mariosgit/performer-hardware/sequencer.kicad_pcb

## KiCad design sequencer.kicad_pcb (continued)

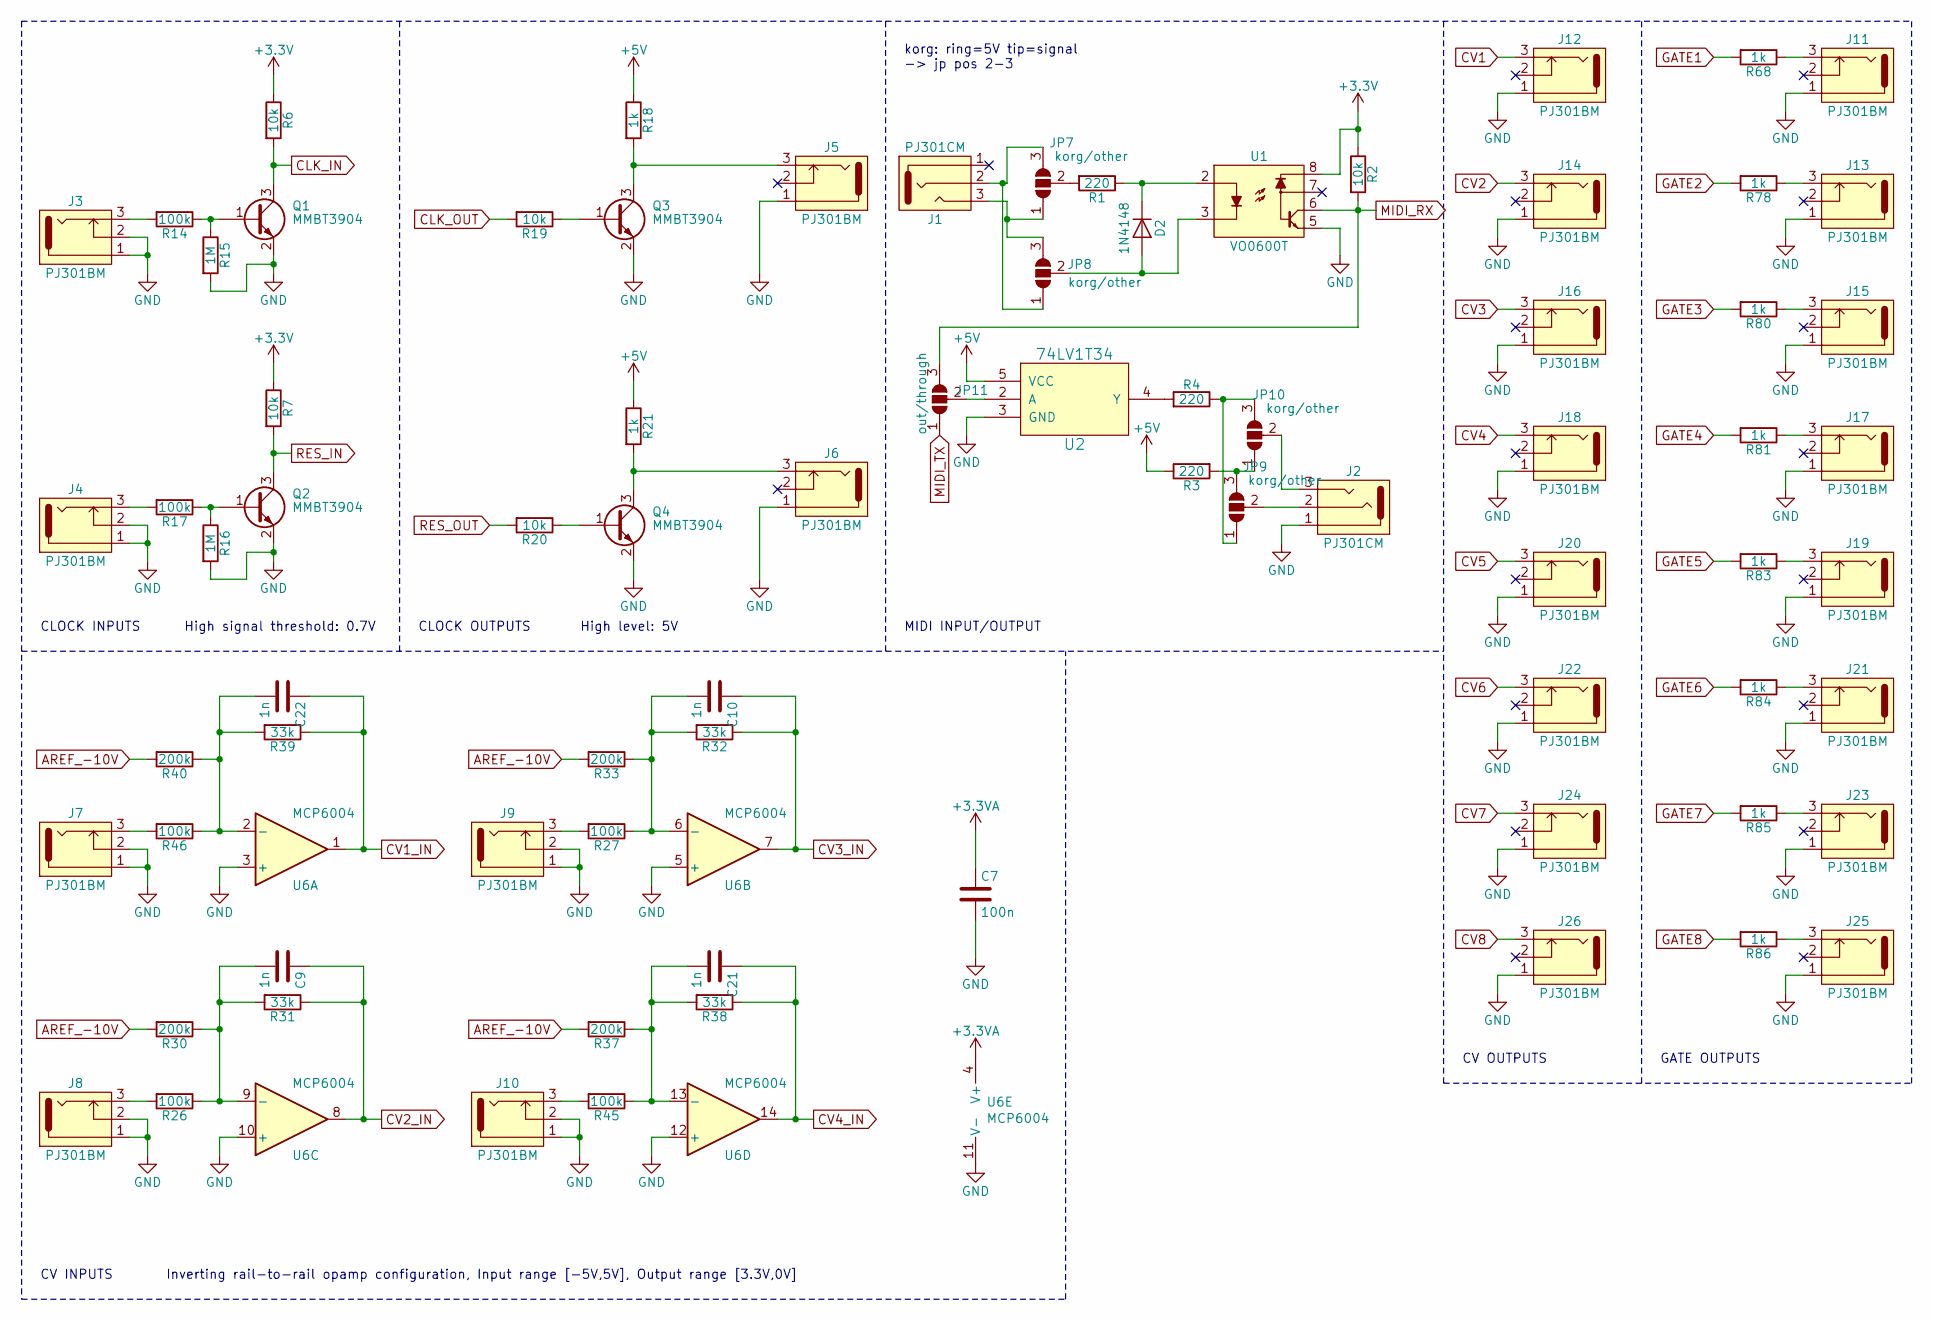
[picture p6: schematic jacks.sch, PER|FORMER eurorack sequencer]

Parts:
C7: 100n; C_0603
C9, C10, C21: 1n; C_0603
C22: 1n; C_0603; LCSC C1588
D2: 1N4148; D_SOD-123
J1, J2: PJ301CM; PJ301CM_OFFSET
J3, J4, J5, J6, J7, J8, J9, J10, J11, J12, J13, J14, J15, J16, J17, J18, J19, J20, J21, J22, J23, J24, J25, J26: PJ301BM
JP7, JP8, JP9, JP10: korg/other; SolderJumper-3_P1.3mm_Open_Pad1.0x1.5mm
JP11: out/through; SolderJumper-3_P1.3mm_Open_Pad1.0x1.5mm
Q1, Q2, Q3, Q4: MMBT3904; SOT-23
R1: 220; R_0603; LCSC C22962
R2, R6, R7, R19, R20: 10k; R_0603
R3, R4: 220; R_0603
R14, R17, R26, R27, R45, R46: 100k; R_0603
R15, R16: 1M; R_0603
R18, R21, R68, R78, R80, R81, R83, R84, R85, R86: 1k; R_0603
R30, R33, R37: 200k; R_0603
R31, R32, R38, R39: 33k; R_0603
R40: 200k; R_0603; LCSC C25811
U1: VO0600T; SOIC-8_3.9x4.9mm_P1.27mm
U2: 74LV1T34; SOT-23-5; LCSC C100024
U6: MCP6004; SOIC-14_3.9x8.7mm_P1.27mm; LCSC C7378

Connections:
+3.3VA: C7.1, U6.4 (V+); also elsewhere on the board
+5V: R3.1, R18.1, R21.1, U2.5 (VCC); also elsewhere on the board
AREF_-10V: R30.2, R33.2, R37.2, R40.2; also elsewhere on the board
CLK_IN: Q1.3 (C), R6.2; also elsewhere on the board
CLK_OUT: R19.2; also elsewhere on the board
CV1: J12.3; also elsewhere on the board
CV1_IN: C22.1, R39.1, U6.1; also elsewhere on the board
CV2: J14.3; also elsewhere on the board
CV2_IN: C9.1, R31.1, U6.8; also elsewhere on the board
CV3: J16.3; also elsewhere on the board
CV3_IN: C10.1, R32.1, U6.7; also elsewhere on the board
CV4: J18.3; also elsewhere on the board
CV4_IN: C21.1, R38.1, U6.14; also elsewhere on the board
CV5: J20.3; also elsewhere on the board
CV6: J22.3; also elsewhere on the board
CV7: J24.3; also elsewhere on the board
CV8: J26.3; also elsewhere on the board
GATE1: R68.2; also elsewhere on the board
GATE2: R78.2; also elsewhere on the board
GATE3: R80.2; also elsewhere on the board
GATE4: R81.2; also elsewhere on the board
GATE5: R83.2; also elsewhere on the board
GATE6: R84.2; also elsewhere on the board
GATE7: R85.2; also elsewhere on the board
GATE8: R86.2; also elsewhere on the board
GND: C7.2, J2.1, J3.1, J3.2, J4.1, J4.2, J5.1, J6.1, J7.1, J7.2, J8.1, J8.2, J9.1, J9.2, J10.1, J10.2, J11.1, J12.1, J13.1, J14.1, J15.1, J16.1, J17.1, J18.1, J19.1, J20.1, J21.1, J22.1, J23.1, J24.1, J25.1, J26.1, Q1.2 (E), Q2.2 (E), Q3.2 (E), Q4.2 (E), R15.2, R16.2, U1.5, U2.3 (GND), U6.3 (+), U6.5 (+), U6.10 (+), U6.11 (V-), U6.12 (+); also elsewhere on the board
MIDI_RX: JP11.3 (B), R2.2, U1.6; also elsewhere on the board
MIDI_TX: JP11.1 (A); also elsewhere on the board
unnamed: C9.2, R26.1, R30.1, R31.2, U6.9 (-)
unnamed: C10.2, R27.1, R32.2, R33.1, U6.6 (-)
unnamed: C21.2, R37.1, R38.2, R45.1, U6.13 (-)
unnamed: C22.2, R39.2, R40.1, R46.1, U6.2 (-)
unnamed: D2.1 (K), R1.1, U1.2
unnamed: D2.2 (A), JP8.2 (C), U1.3
unnamed: J1.2, JP7.3 (B), JP8.1 (A)
unnamed: J1.3, JP7.1 (A), JP8.3 (B)
unnamed: J2.2, JP9.2 (C)
unnamed: J2.3, JP10.2 (C)
unnamed: J3.3, R14.2
unnamed: J4.3, R17.2
unnamed: J5.3, Q3.3 (C), R18.2
unnamed: J6.3, Q4.3 (C), R21.2
unnamed: J7.3, R46.2
unnamed: J8.3, R26.2
unnamed: J9.3, R27.2
unnamed: J10.3, R45.2
unnamed: J11.3, R68.1
unnamed: J13.3, R78.1
unnamed: J15.3, R80.1
unnamed: J17.3, R81.1
unnamed: J19.3, R83.1
unnamed: J21.3, R84.1
unnamed: J23.3, R85.1
unnamed: J25.3, R86.1
unnamed: JP7.2 (C), R1.2
unnamed: JP9.3 (B), JP10.1 (A), R3.2
unnamed: JP9.1 (A), JP10.3 (B), R4.1
unnamed: JP11.2 (C), U2.2 (A)
unnamed: Q1.1 (B), R14.1, R15.1
unnamed: Q2.1 (B), R16.1, R17.1
unnamed: Q3.1 (B), R19.1
unnamed: Q4.1 (B), R20.1
unnamed: R4.2, U2.4 (Y)
RES_IN: Q2.3 (C), R7.2; also elsewhere on the board
RES_OUT: R20.2; also elsewhere on the board

Notes on the sheet:
CLOCK INPUTS
GATE OUTPUTS
CV OUTPUTS
MIDI INPUT/OUTPUT
CLOCK OUTPUTS
CV INPUTS
High signal threshold: 0.7V
High level: 5V
Inverting rail-to-rail opamp configuration, Input range [-5V,5V], Output range [3.3V,0V]
korg: ring=5V tip=signal -> jp pos 2-3

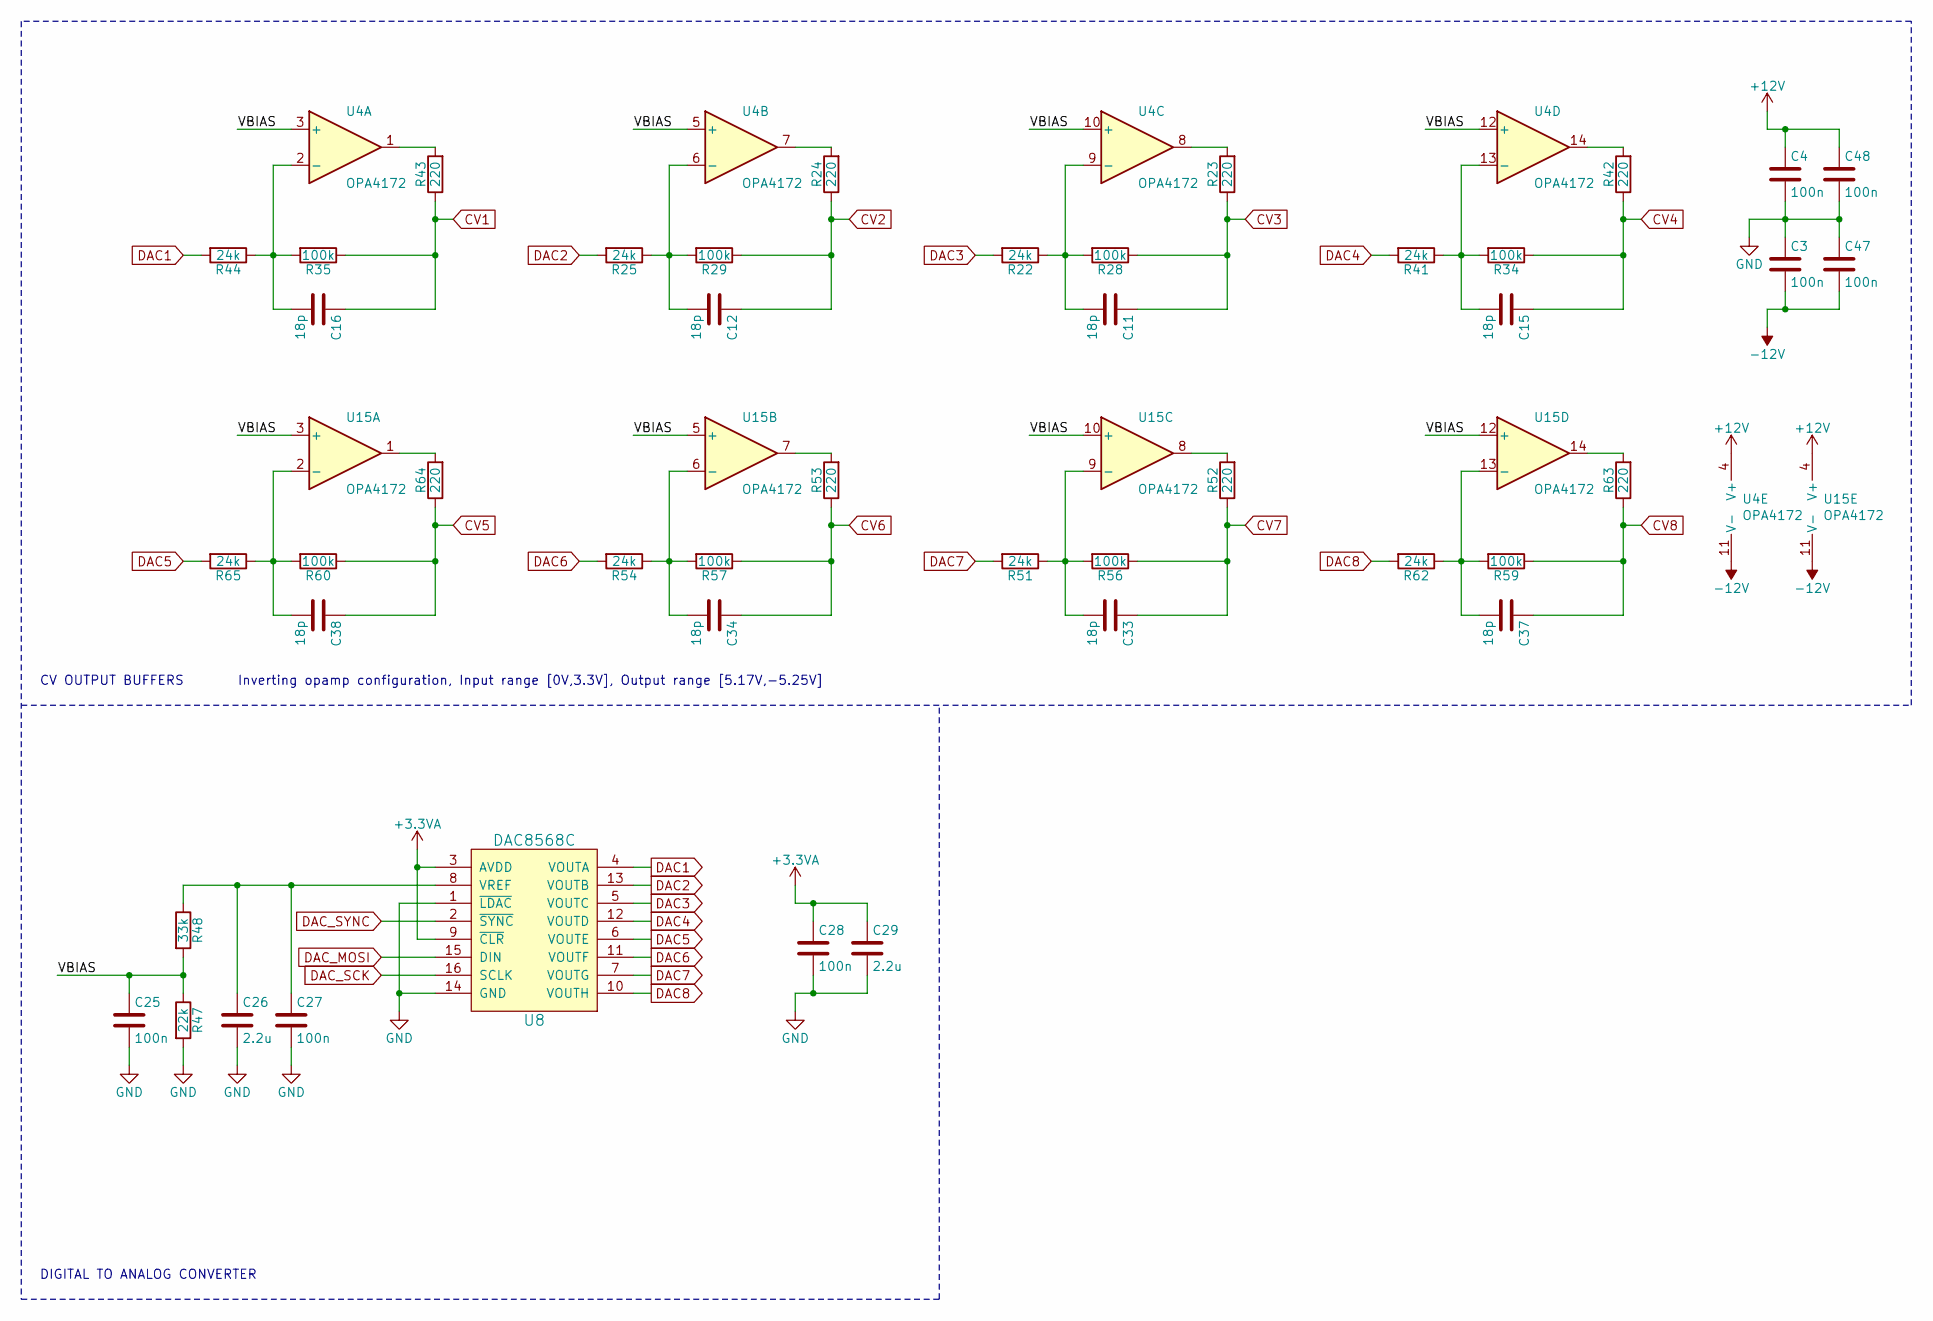
[picture p7: schematic dac.sch, PER|FORMER eurorack sequencer]

Parts:
C3, C4, C25, C27, C28, C47, C48: 100n; C_0603
C11, C12, C15, C16, C33, C34, C37, C38: 18p; C_0603
C26, C29: 2.2u; C_0805
R22, R25, R41, R51, R54, R62, R65: 24k; R_0603
R23, R24, R42, R43, R52, R53, R63, R64: 220; R_0603
R28, R29, R34, R35, R56, R57, R59, R60: 100k; R_0603
R44: 24k; R_0603; LCSC C23352
R47: 22k; R_0603; LCSC C31850
R48: 33k; R_0603
U4, U15: OPA4172; SOIC-14_3.9x8.7mm_P1.27mm
U8: DAC8568C; TSSOP-16_4.4x5mm_P0.65mm

Connections:
+3.3VA: C28.1, C29.1, U8.3 (AVDD), U8.9 (~CLR); also elsewhere on the board
+12V: C4.1, C48.1, U4.4 (V+), U15.4 (V+); also elsewhere on the board
-12V: C3.2, C47.2, U4.11 (V-), U15.11 (V-); also elsewhere on the board
/DAC/VBIAS: C25.1, R47.1, R48.2, U4.3 (+), U4.5 (+), U4.10 (+), U4.12 (+), U15.3 (+), U15.5 (+), U15.10 (+), U15.12 (+)
CV1: C16.1, R35.1, R43.1; also elsewhere on the board
CV2: C12.1, R24.1, R29.1; also elsewhere on the board
CV3: C11.1, R23.1, R28.1; also elsewhere on the board
CV4: C15.1, R34.1, R42.1; also elsewhere on the board
CV5: C38.1, R60.1, R64.1; also elsewhere on the board
CV6: C34.1, R53.1, R57.1; also elsewhere on the board
CV7: C33.1, R52.1, R56.1; also elsewhere on the board
CV8: C37.1, R59.1, R63.1; also elsewhere on the board
DAC1: R44.2, U8.4 (VOUTA)
DAC2: R25.2, U8.13 (VOUTB)
DAC3: R22.2, U8.5 (VOUTC)
DAC4: R41.2, U8.12 (VOUTD)
DAC5: R65.2, U8.6 (VOUTE)
DAC6: R54.2, U8.11 (VOUTF)
DAC7: R51.2, U8.7 (VOUTG)
DAC8: R62.2, U8.10 (VOUTH)
DAC_MOSI: U8.15 (DIN); also elsewhere on the board
DAC_SCK: U8.16 (SCLK); also elsewhere on the board
DAC_SYNC: U8.2 (~SYNC); also elsewhere on the board
GND: C3.1, C4.2, C25.2, C26.2, C27.2, C28.2, C29.2, C47.1, C48.2, R47.2, U8.1 (~LDAC), U8.14 (GND); also elsewhere on the board
unnamed: C11.2, R22.1, R28.2, U4.9 (-)
unnamed: C12.2, R25.1, R29.2, U4.6 (-)
unnamed: C15.2, R34.2, R41.1, U4.13 (-)
unnamed: C16.2, R35.2, R44.1, U4.2 (-)
unnamed: C26.1, C27.1, R48.1, U8.8 (VREF)
unnamed: C33.2, R51.1, R56.2, U15.9 (-)
unnamed: C34.2, R54.1, R57.2, U15.6 (-)
unnamed: C37.2, R59.2, R62.1, U15.13 (-)
unnamed: C38.2, R60.2, R65.1, U15.2 (-)
unnamed: R23.2, U4.8
unnamed: R24.2, U4.7
unnamed: R42.2, U4.14
unnamed: R43.2, U4.1
unnamed: R52.2, U15.8
unnamed: R53.2, U15.7
unnamed: R63.2, U15.14
unnamed: R64.2, U15.1

Notes on the sheet:
CV OUTPUT BUFFERS
DIGITAL TO ANALOG CONVERTER
Inverting opamp configuration, Input range [0V,3.3V], Output range [5.17V,-5.25V]

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
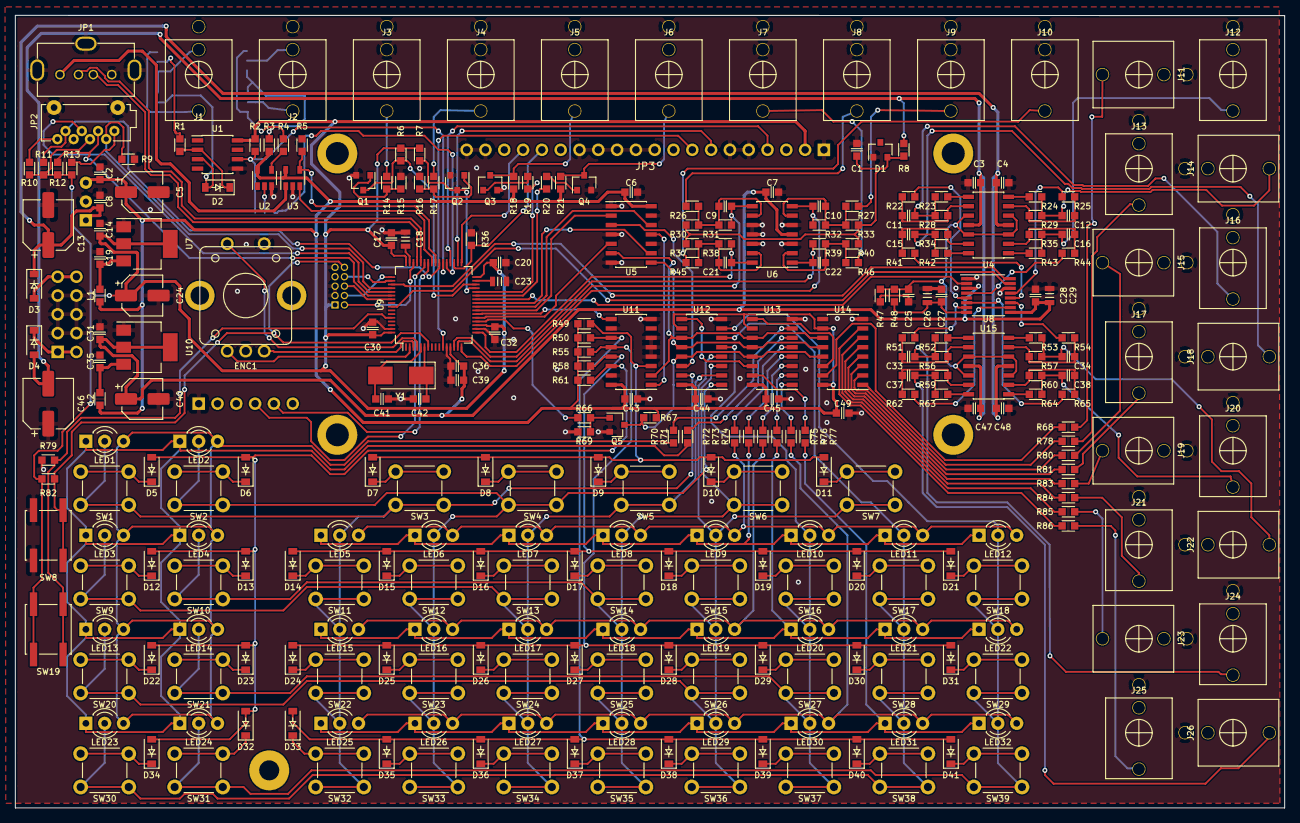
[picture p8: board sequencer.kicad_pcb from above]

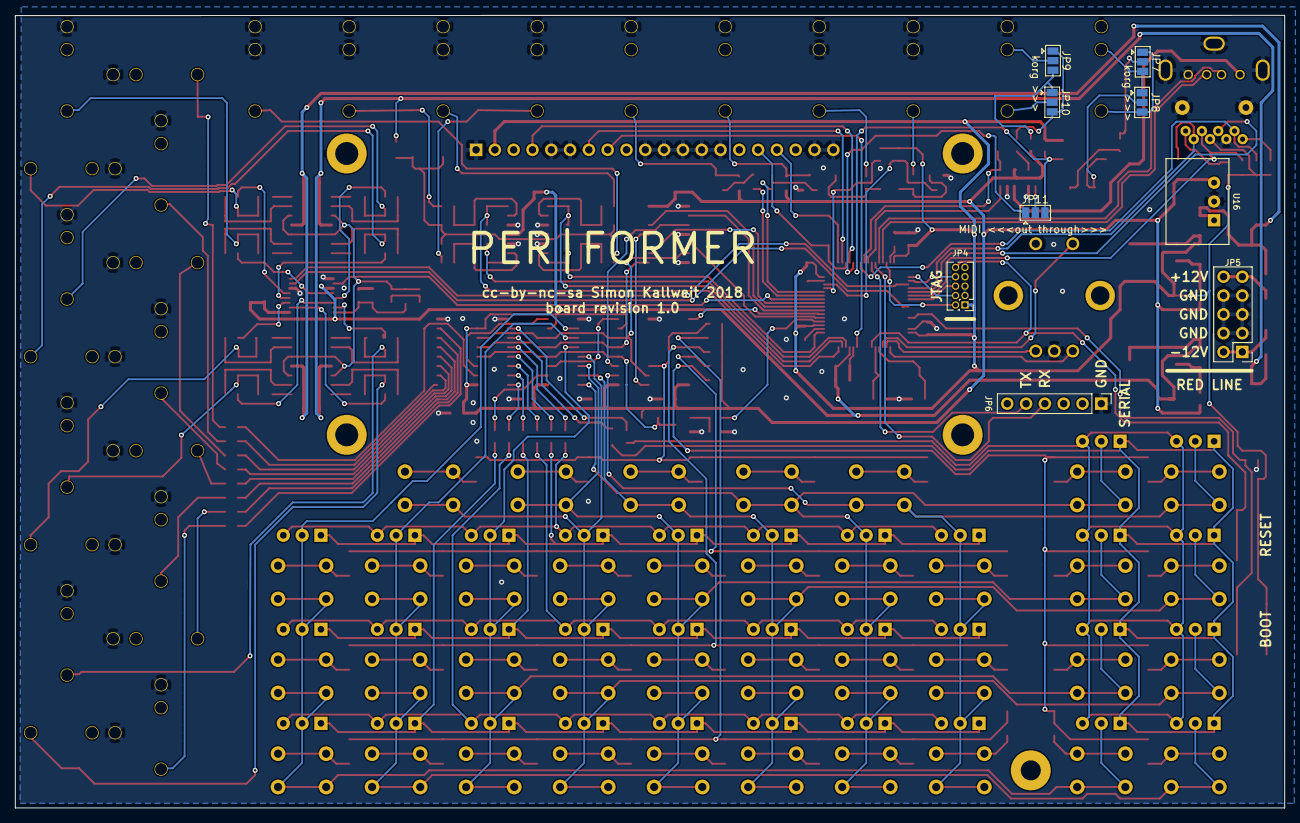
[picture p9: board sequencer.kicad_pcb from below]

Board: 2 copper layers, 171.4 x 107.1 mm, 309 parts (9 on the bottom side), 212 nets.
