mariosgit/performer-hardware/(commit log)

2020-06-18 Added JCLC part numbers.
    [button-matrix.sch, dac.sch, global.sch, jacks.sch, led-matrix.sch, mcu.sch, power.sch, sequencer.sch]
2020-06-19 Added solder jumpers for midi polarity and midi out/through.
    [jacks.sch, sequencer.kicad_pcb]
2020-06-19 Changed jack footprints to pj301cm.
    [frontpanel-Edge.Cuts.gm1, frontpanel-F.Mask.gts, frontpanel-F.SilkS.gto, frontpanel-NPTH.drl, sequencer-B.Cu.gbl, sequencer-B.Mask.gbs, sequencer-B.Paste.gbp, sequencer-B.SilkS.gbo]
2020-06-19 removed gerbers
    [sequencer-NPTH.drl]
2020-06-26 Fixed LCSC values.
    [button-matrix.sch, dac.sch, global.sch, jacks.sch, led-matrix.sch, mcu.sch, power.sch, sequencer.sch]
2020-11-15 Some cleanup. Frontpanel with Copper Labels.
    [frontpanel.kicad_pcb, global.sch, jacks.sch, sequencer.kicad_pcb]
